BodyTrack/Schematic_ChestStrap/README

Schematics for the BodyTrack ChestStrap device.

PDF's are included incase you do not have eagle.

Gerber files are included in the zip files. 

Parts list, BOM and CPL for manufacturing is included in excel file.
