BodyTrack/Schematic_ChestStrap/ChestStrapV3_BOM.xlsx

Quantity | Reference | Part | Part Number | Distributor
1 | XMEGA_256_A3B | Xmega | ATXMEGA256A3B-MH-ND | Digikey
1 | FT232RQ | ftdi | 768-1008-1-ND | Digikey
1 | INA326 | intrumentation amp | INA326EA/2K5CT-ND | Digikey
2 | OPA333 | opamp | 296-19546-1-ND | Digikey
1 | MIC5205 | regulator | 576-1259-1-ND | Digikey
1 | LTC2941 | fuel gauge | LTC2941CDCB-1#TRMPBFCT-ND | Digikey
1 | MCP73831 | battery charger | MCP73831T-2DCI/OTCT-ND | Digikey
1 | MAIN_OSC | oscillator | 631-1070-1-ND | Digikey
1 | RTC_OSC | crystal | 535-9544-1-ND | Digikey
3 | D1,D2,D3 | esd diode | CDSOT23-S2004CT-ND | Digikey
1 | HIH-5030 | humidity | 480-3294-1-ND | Digikey
1 | ADXL345 | accelerometer | ADXL345BCCZ-RLCT-ND | Digikey
2 | LED1,LED2 | green led | L62505CT-ND | Digikey
1 | LED3 | red led | L62501CT-ND | Digikey
1 | BUTTON | button | EG1868CT-ND | Digikey
1 | SWITCH | switch | 401-1999-1-ND | Digikey
1 | USD-SOCKETNEW | microSD | 101-00660-68-6-1-ND | Digikey
1 | MICROB_SM | usb | H11634CT-ND | Digikey
1 | 5-HEADER_JST_SM | 5-pin connector | 455-1696-1-ND | Digikey
1 | R24 | 100 | RHM100ARCT-ND | Digikey
3 | R20,R21,R23 | 422 | RHM422CRCT-ND | Digikey
2 | R31,R32 | 1k (0.1%) | RG20P1.0KBCT-ND | Digikey
4 | R5,R12,R15,R16 | 2k | RMCF0805JT2K00CT-ND | Digikey
2 | R13,R25 | 12k (0.5%) | RR12P12.0KDCT-ND | Digikey
3 | R6,R17,R22 | 10k | RHM10.0KCRCT-ND | Digikey
3 | R9,R100,R101 | 10k (0.5%) | RR12P10.0KDCT-ND | Digikey
2 | R14,R26 | 20k (0.5%) | RR12P20.0KDCT-ND | Digikey
4 | R1,R19,R29,R30 | 22k | RHM22KARCT-ND | Digikey
2 | R38,R39 | 32.4k (0.5%) | RR12P32.4KDCT-ND | Digikey
2 | R2,R3 | 100k | RMCF0805FT100KCT-ND | Digikey
1 | R4 | 430k | RHM430KARCT-ND | Digikey
5 | R7,R8,R10,R11,R18 | 1M | RHM1.0MARCT-ND | Digikey
2 | C8,C9 | 15pF | 709-1170-1-ND | Digikey
3 | C13,C17,C18 | 47pF | 709-1175-1-ND | Digikey
1 | C33 | 100pF | 709-1176-1-ND | Digikey
1 | C34 | 470pF | 311-1124-1-ND | Digikey
1 | C27 | 10000pF | 478-1383-1-ND | Digikey
15 | C1,C5,C7,C10,C11,C12,C16,C20,C25,C26,C28,C31,C32,C36,C59 | 0.1uF | 478-3352-1-ND | Digikey
3 | C2,C3,C4 | 1uF | 311-1358-1-ND | Digikey
1 | C22 | 2.2uF | 478-3864-1-ND | Digikey
4 | C23,C24,C29,C30 | 4.7uF | 478-3867-1-ND | Digikey
2 | C6,C21 | 10uF | 478-1656-1-ND | Digikey
