BodyTrack/Schematic_ChestStrap/CheststrapV3_Parts.xlsx

Part | Quantity | price | ext price | part number
Ics
Xmega | 1 | 14.5 | 14.5 | ATXMEGA256A3B-MH-ND
ftdi | 1 | 4.5 | 4.5 | 768-1008-1-ND
intrumentation amp | 1 | 5.4 | 5.4 | INA326EA/2K5CT-ND
opamp | 2 | 3.3 | 6.6 | 296-19546-1-ND
regulator | 1 | 0.66 | 0.66 | 576-1259-1-ND
fuel gauge | 1 | 4.03 | 4.03 | LTC2941CDCB-1#TRMPBFCT-ND
battery charger | 1 | 0.68 | 0.68 | MCP73831T-2DCI/OTCT-ND
oscillator | 1 | 6.41 | 6.41 | 631-1070-1-ND
crystal | 1 | 1.58 | 1.58 | 535-9544-1-ND
esd diode | 3 | 0.24 | 0.72 | CDSOT23-S2004CT-ND
humidity | 1 | 11.45 | 11.45 | 480-3294-1-ND
accelerometer | 1 | 8.16 | 8.16 | ADXL345BCCZ-RLCT-ND
green led | 2 | 0.32 | 0.64 | L62505CT-ND
red led | 1 | 0.32 | 0.32 | L62501CT-ND
button | 1 | 0.75 | 0.75 | EG1868CT-ND
switch | 1 | 0.98 | 0.98 | 401-1999-1-ND
connectors
microSD | 1 | 1.97 | 1.97 | 101-00660-68-6-1-ND
usb | 1 | 1.06 | 1.06 | H11634CT-ND
respiration/temp | 1 | 0.65 | 0.65 | 455-1696-1-ND
Resistors 0805
100 | 1 | 0.033 | 0.033 | RHM100ARCT-ND
422 | 3 | 0.042 | 0.126 | RHM422CRCT-ND
1k (0.1%) | 2 | 0.409 | 0.818 | RG20P1.0KBCT-ND
2k | 4 | 0.03 | 0.12 | RMCF0805JT2K00CT-ND
12k (0.5%) | 2 | 0.148 | 0.296 | RR12P12.0KDCT-ND
10k | 3 | 0.042 | 0.126 | RHM10.0KCRCT-ND
10k (0.5%) | 3 | 0.148 | 0.444 | RR12P10.0KDCT-ND
20k (0.5%) | 2 | 0.148 | 0.296 | RR12P20.0KDCT-ND
22k | 4 | 0.033 | 0.132 | RHM22KARCT-ND
32.4k (0.5%) | 2 | 0.148 | 0.296 | RR12P32.4KDCT-ND
100k | 2 | 0.04 | 0.08 | RMCF0805FT100KCT-ND
430k | 1 | 0.033 | 0.033 | RHM430KARCT-ND
1M | 5 | 0.033 | 0.165 | RHM1.0MARCT-ND
Capacitor (ceramic) 0805
15pF | 2 | 0.044 | 0.088 | 709-1170-1-ND
47pF | 3 | 0.044 | 0.132 | 709-1175-1-ND
100pF | 1 | 0.044 | 0.044 | 709-1176-1-ND
470pF | 1 | 0.048 | 0.048 | 311-1124-1-ND
10000pF | 1 | 0.029 | 0.029 | 478-1383-1-ND
0.1uF | 15 | 0.05 | 0.75 | 478-3352-1-ND
1uF | 3 | 0.039 | 0.117 | 311-1358-1-ND
Capacitor (tantalum) 1206
2.2uF | 1 | 0.34 | 0.34 | 478-3864-1-ND
4.7uF | 4 | 0.38 | 1.52 | 478-3867-1-ND
10uF | 2 | 0.38 | 0.76 | 478-1656-1-ND
other
sd card | 1 | 20.99 | 20.99 | http://www.amazon.com/Patriot-Signature-MicroSDHC-Memory-PSF8GMCSDHC10/dp/B004CDI8MS
temp sensor | 1 | 3.6 | 3.6 | 317-1305-ND
sensor cable | 1 | 4 | 4 | http://www.acroname.com/robotics/parts/C19-5PIN-JST-CONN.html
usb cables | 1 | 4.99 | 4.99 | http://www.amazon.com/Mediabridge--Male-Micro-B-Cable-Feet/dp/B004GF8TIK
battery | 1 | 11.95 | 11.95 | http://www.sparkfun.com/products/339
 |  | Total: | 77.853
Only once:
mill max pins | 6 | 1.45 | 8.7 | Mouser: 575-929152
isp | 1 | 0.26 | 0.26 | 3M9459-ND
snaps | 3 |  | 0 | Jo-anns
