BodyTrack/Schematic_ChestStrap/(list of files, cad)

Other CAD files:
ChestStrapV2.stl
