BodyTrack/Schematic_ChestStrap/ChestStrapV3Layout.pdf

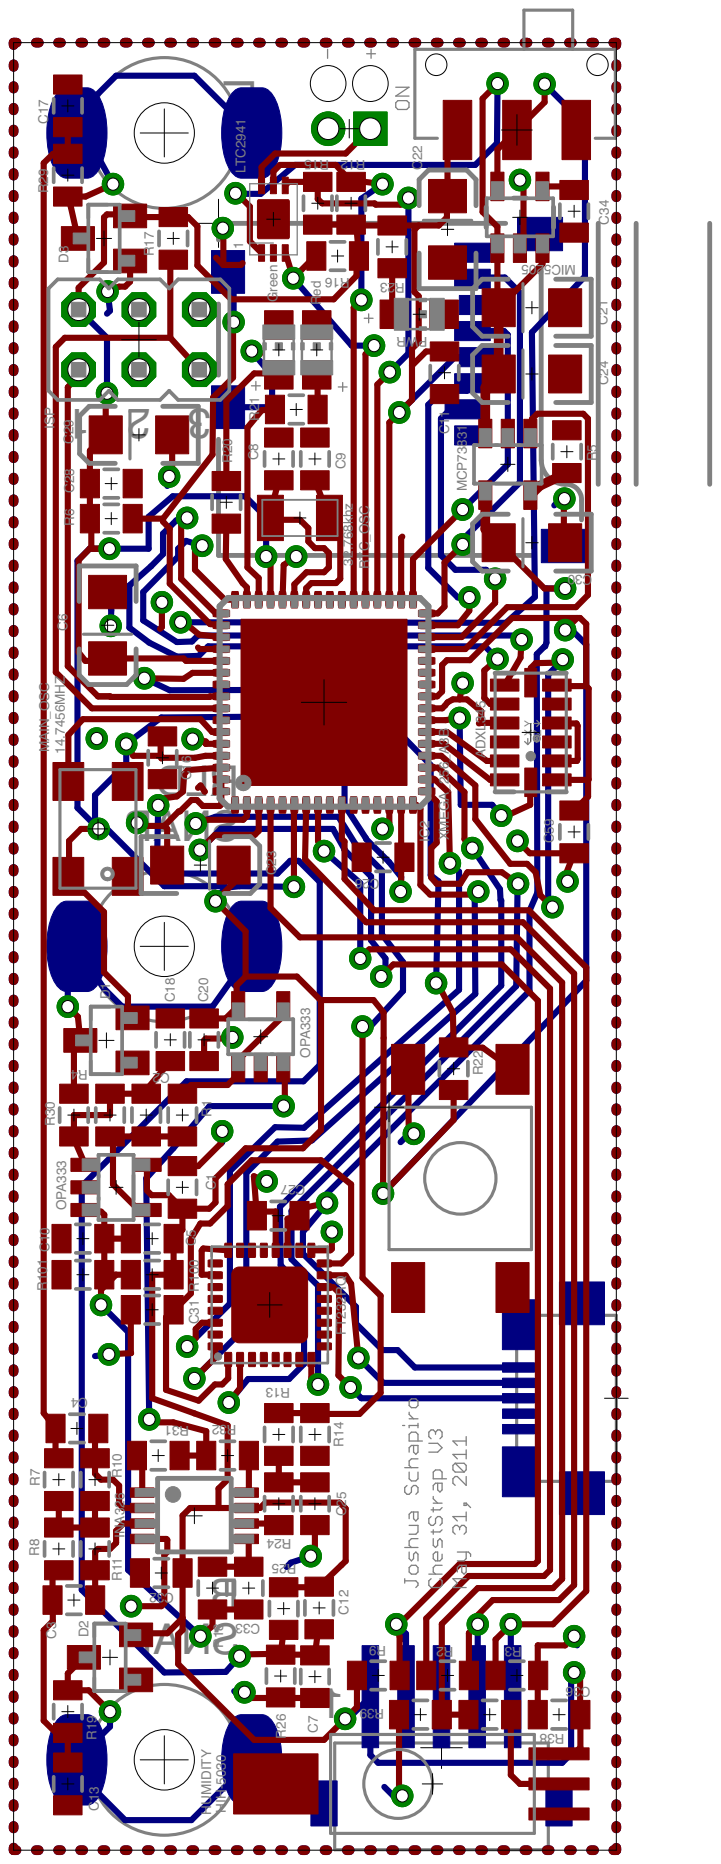
[picture p2: page 1]
