BodyTrack/Schematic_ChestStrap/ChestStrapV3Schematic.pdf

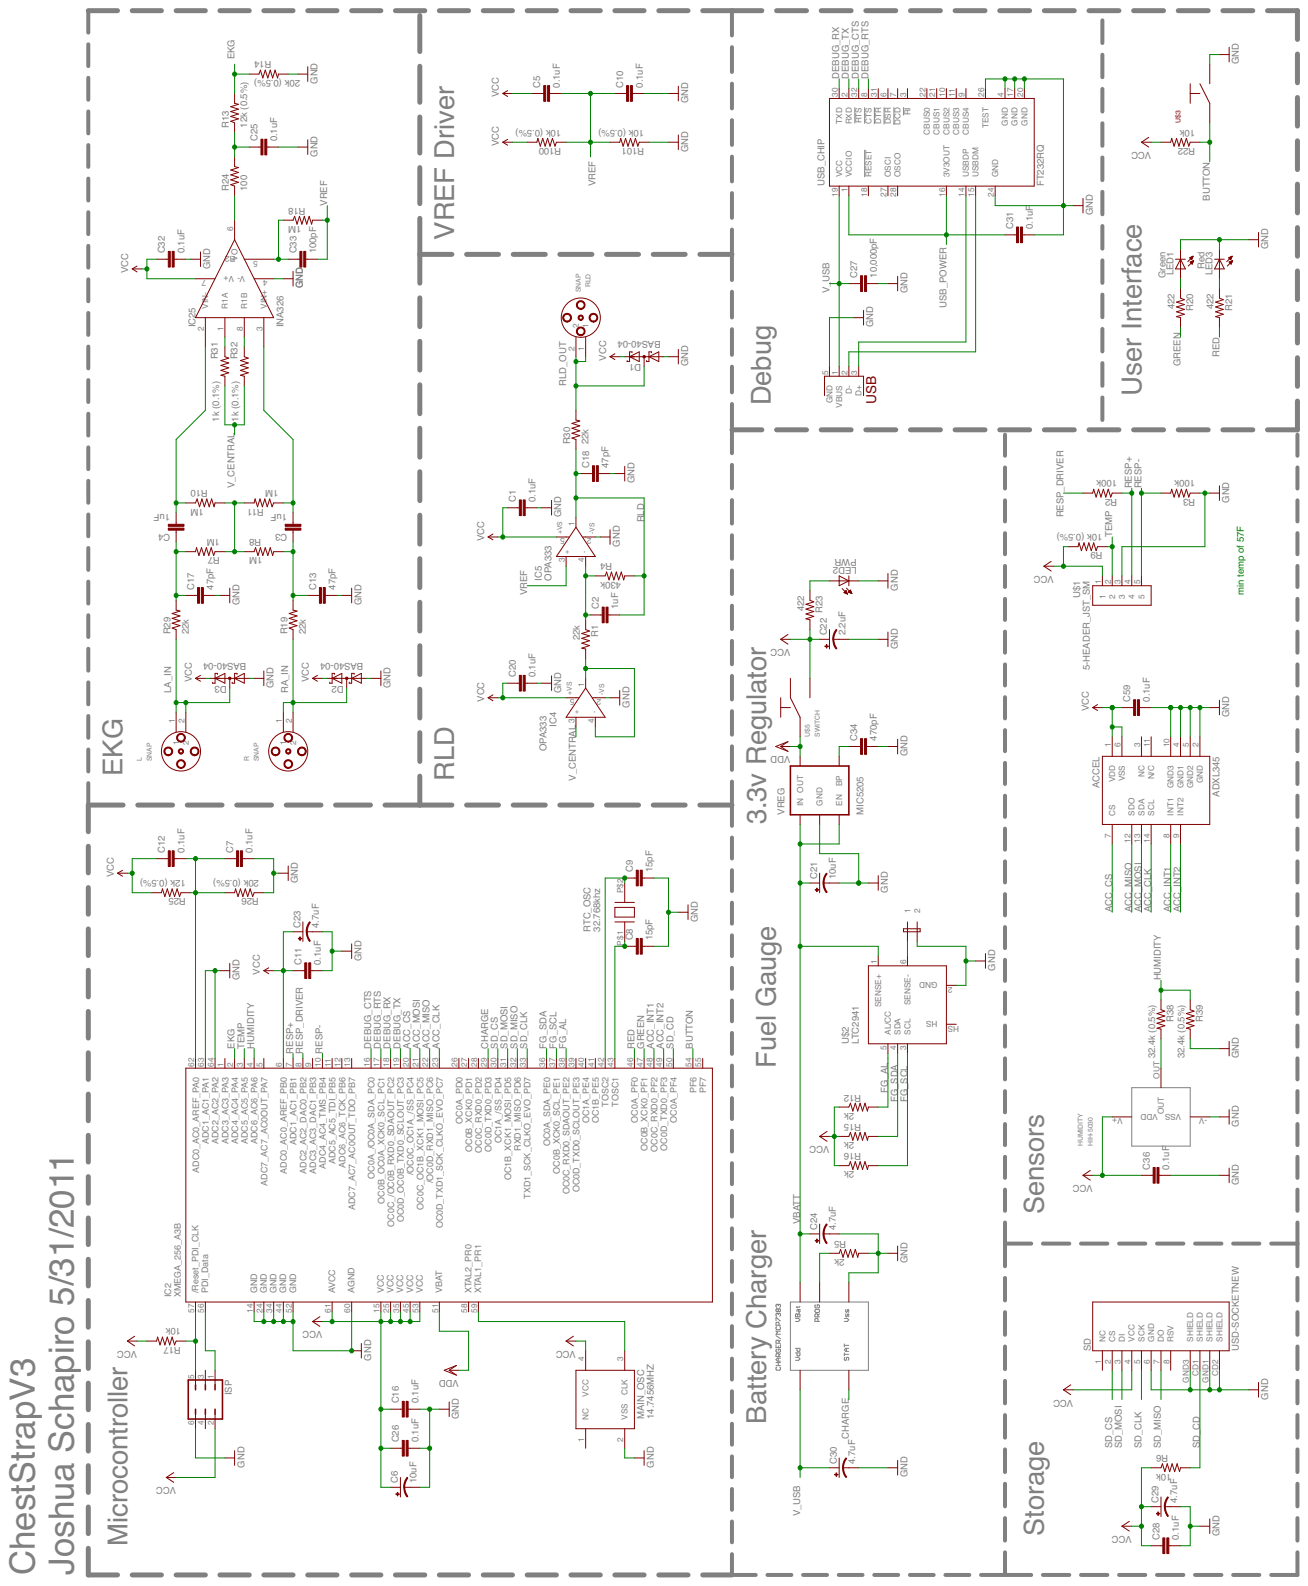
[picture p1: page 1]

/Reset_PDI_CLK GND GND GND GND GND
